hsgw/knot/readme.md

# knot

knot is a trackball with 2x2 choc v2 switch on ZMK Firmware

WIP

## Build guide

[ビルドガイド(日本語)](knot_build_guide_jp.md)

## Firmware

https://github.com/hsgw/zmk-config-knot

## case 3D models

[3dmodels](3dmodels/)
