hsgw/knot/imgs/P3163941.jpg

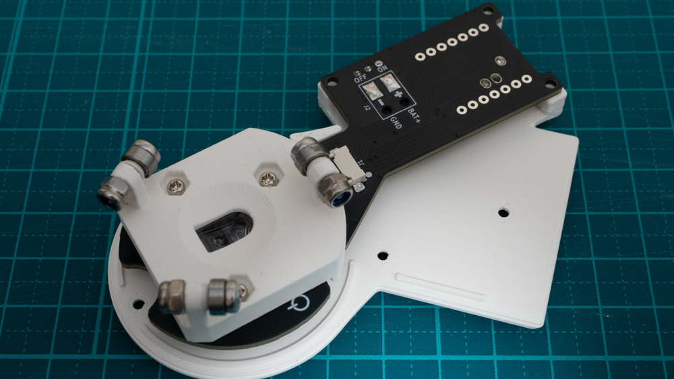
imgs/P3163941.jpg
