hsgw/knot/imgs/P3163947.jpg

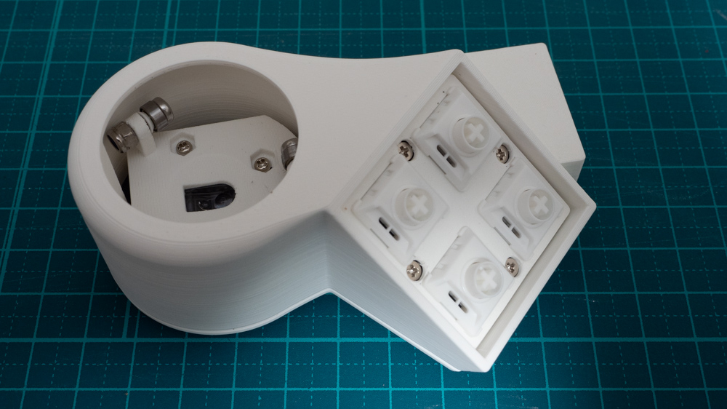
imgs/P3163947.jpg
