hsgw/knot/imgs/P3163951.jpg

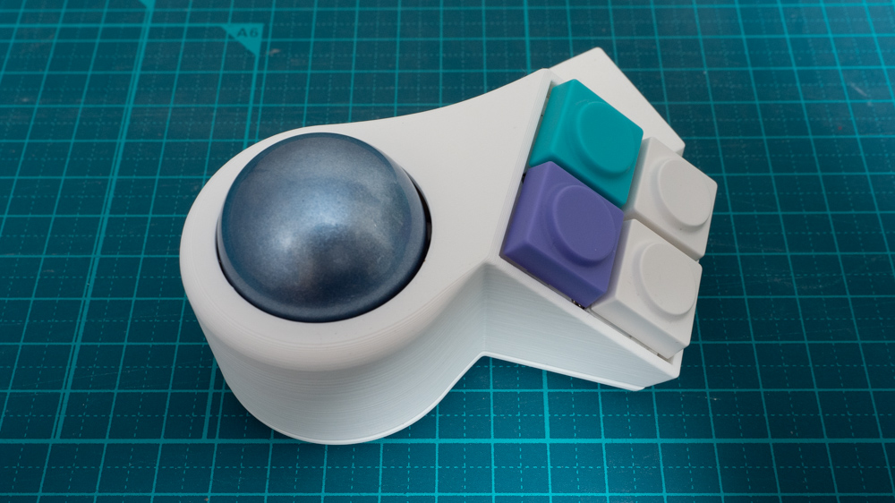
imgs/P3163951.jpg
