hsgw/knot/3dmodels/rev.Alpha/knot_mcu.stl

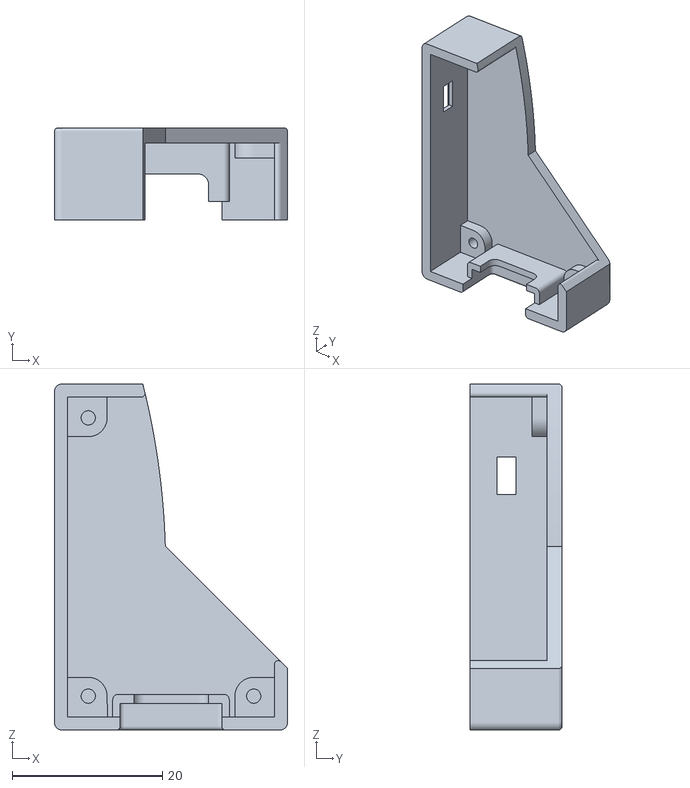
[picture p5: CAD file, 2025-03-26]
3dmodels/rev.Alpha/knot_mcu.stl
31.0 x 12.3 x 46.0
