hsgw/knot/3dmodels/rev.Alpha/knot_bottom.stl

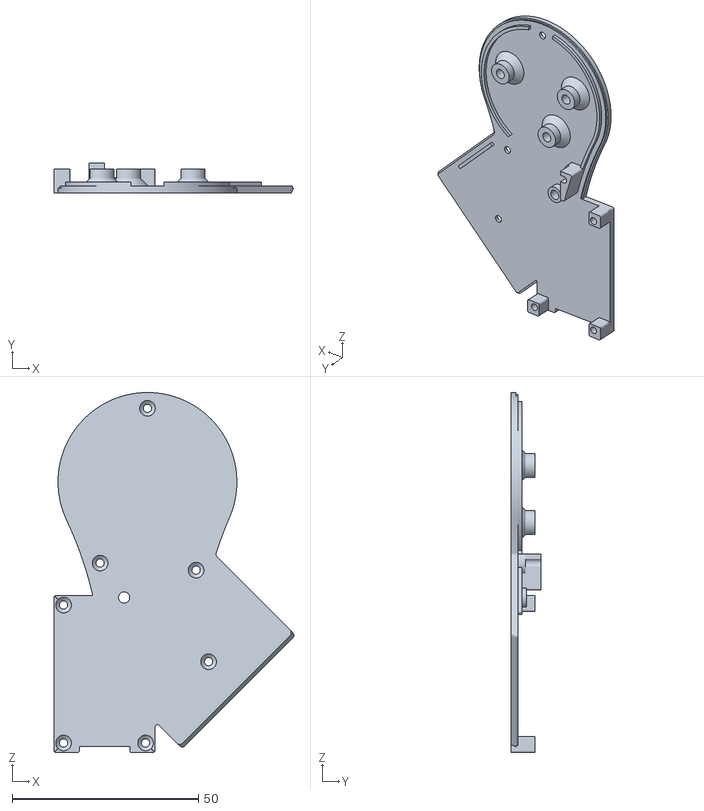
[picture p6: CAD file, 2025-03-26]
3dmodels/rev.Alpha/knot_bottom.stl
64.3 x 8.14 x 96.6
