hsgw/knot/3dmodels/rev.Alpha/knot_sw_plate.stl

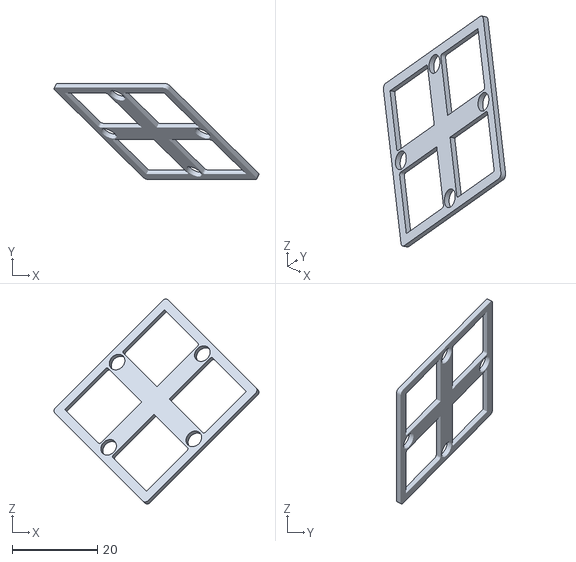
[picture p7: CAD file, 2025-03-26]
3dmodels/rev.Alpha/knot_sw_plate.stl
48.0 x 22.5 x 48.0
