hsgw/knot/3dmodels/rev.Alpha/bearing_spacer.stl

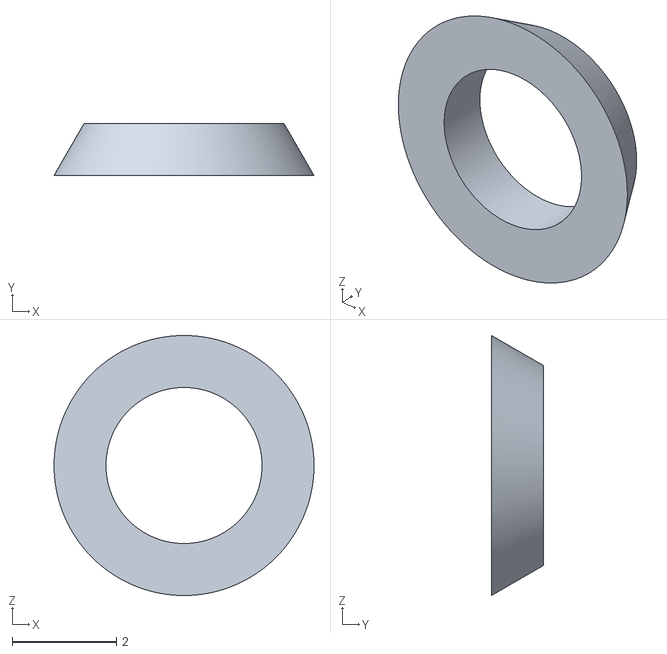
[picture p8: CAD file, 2025-03-26]
3dmodels/rev.Alpha/bearing_spacer.stl
5.00 x 1.00 x 5.00
