hsgw/knot/3dmodels/rev.Alpha/knot_top.stl

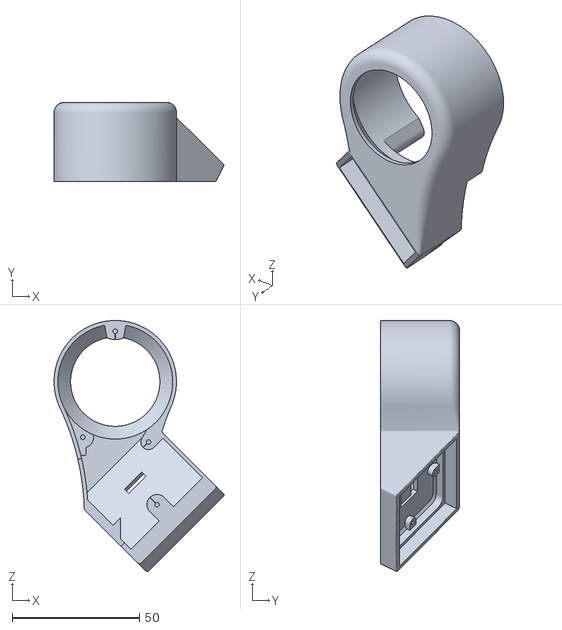
[picture p9: CAD file, 2025-03-26]
3dmodels/rev.Alpha/knot_top.stl
66.6 x 31.1 x 98.4
