hsgw/knot/3dmodels/rev.Alpha/knot_ball_holder.stl

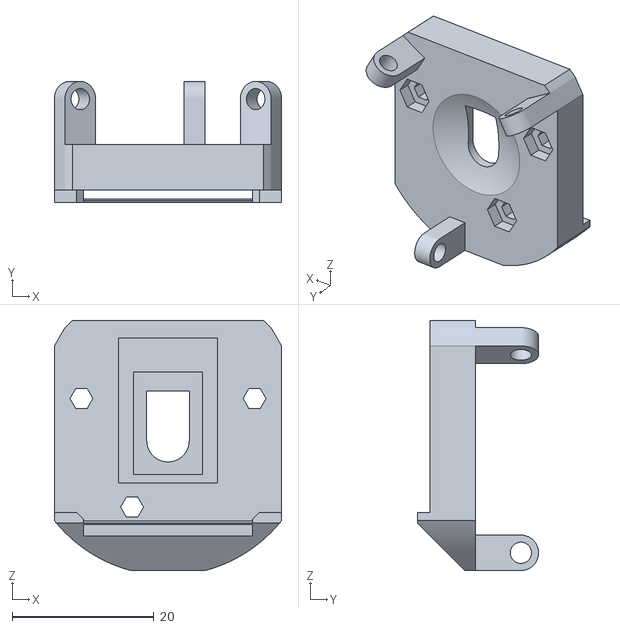
[picture p10: CAD file, 2025-03-26]
3dmodels/rev.Alpha/knot_ball_holder.stl
32.1 x 17.1 x 35.3
